pradeepkumardevoorsangappa/XY_Pen_Plotter/Image.jpg

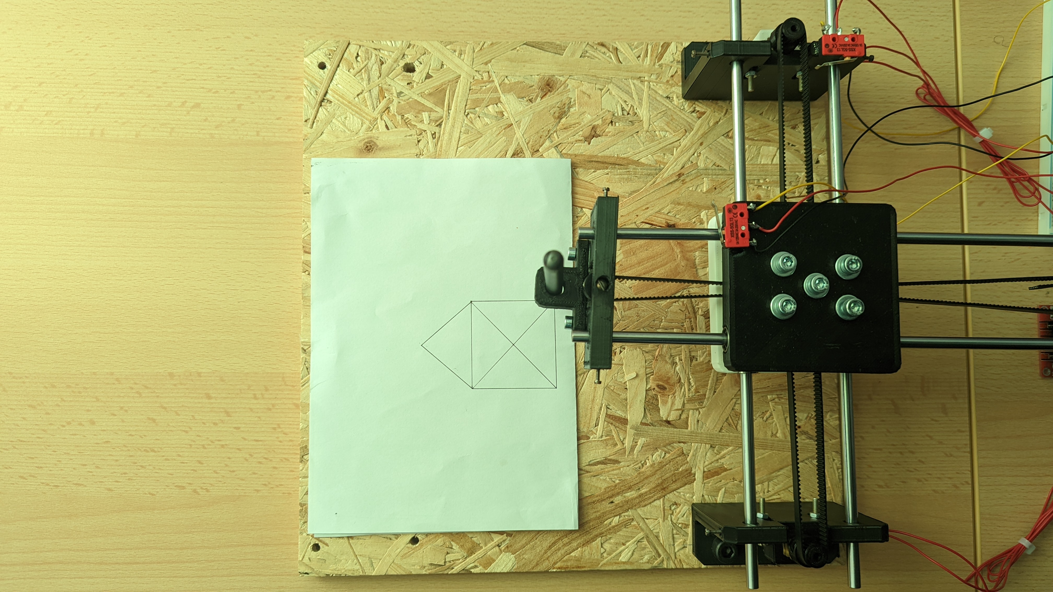
Image.jpg
