pradeepkumardevoorsangappa/XY_Pen_Plotter/README.md

# XY_Pen_Plotter

Arduino programming to set the Motors high and low. 
Successfully implemented the new control system resulting in more accurate outcomes.
